345ljh/Artisans_Tome/(list of files, drawings)

Other design files:
pcb/weather.eprj
