345ljh/Artisans_Tome/(commit log)

2025-09-30 update osskey, document and prompt
    [weather.eprj]
2025-09-30 update document and bom
    [BOM_Board1_Schematic1_2025-09-30.xlsx, weather.eprj]
2025-10-02 modulize functions of img_gen
    [weather.eprj]
